PubInv/GlussCon/_posts/2015-08-24-stator-3d.md

---
layout: post
title: A 3D-printed Stator
---

<section class="content">
      <div class="jumbotron">
        <h1> A 3D-printed Stator</h1>
      </div>

<h1> Stator Design </h1>

<p>
With considerable effort, I created a 3D-printable design for the Gluss Pusher Stator.  The stator is the part that holds the coils. The pushrod holds the magnets.
</p>

Gluss Pusher Stator V24

<p>
I did this in Autodesk Fusion 360, and my design is freely <a href="https://fusion360.autodesk.com/projects/gluss-pusher-stator-v24">reusable</a> under Creative Commons Share Alike 4.0 license.
</p>

<br /><span xmlns:dct="http://purl.org/dc/terms/" href="http://purl.org/dc/dcmitype/Text" property="dct:title" rel="dct:type">Gluss Pusher Stator</span> by <a xmlns:cc="http://creativecommons.org/ns#" href="https://github.com/PubInv/PubInv" property="cc:attributionName" rel="cc:attributionURL">Robert L. Read</a> is licensed under a <a rel="license" href="http://creativecommons.org/licenses/by-sa/4.0/">Creative Commons Attribution-ShareAlike 4.0 International License</a>.<br />Based on a work at <a xmlns:dct="http://purl.org/dc/terms/" href="https://github.com/PubInv/PubInv" rel="dct:source">https://github.com/PubInv/PubInv</a>.

</section>
