PubInv/GlussCon/doc/figures/7TetController/7TetController.JPG

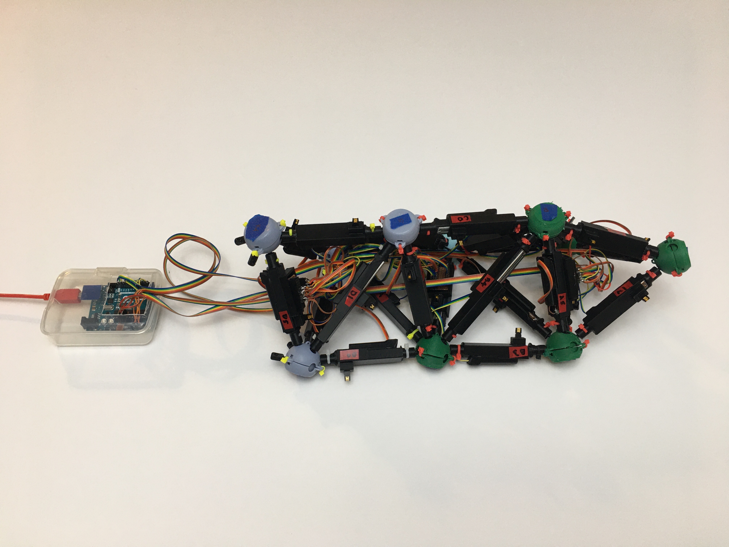
doc/figures/7TetController/7TetController.JPG
