PubInv/GlussCon/doc/figures/7TetController/BentArm.JPG

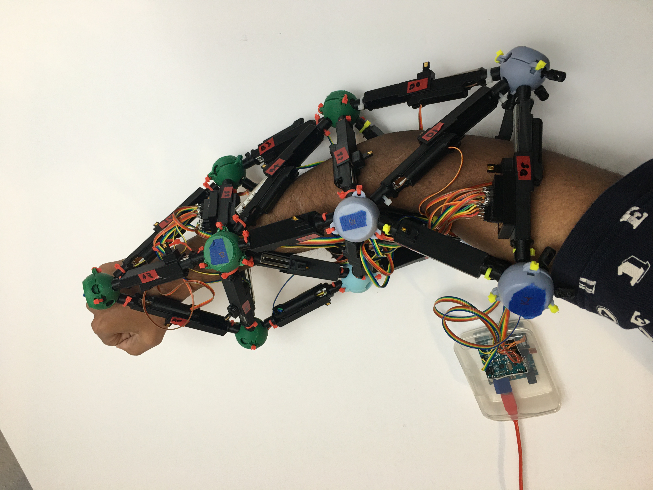
doc/figures/7TetController/BentArm.JPG
