PubInv/GlussCon/doc/figures/7TetController/JointAndSleeve.JPG

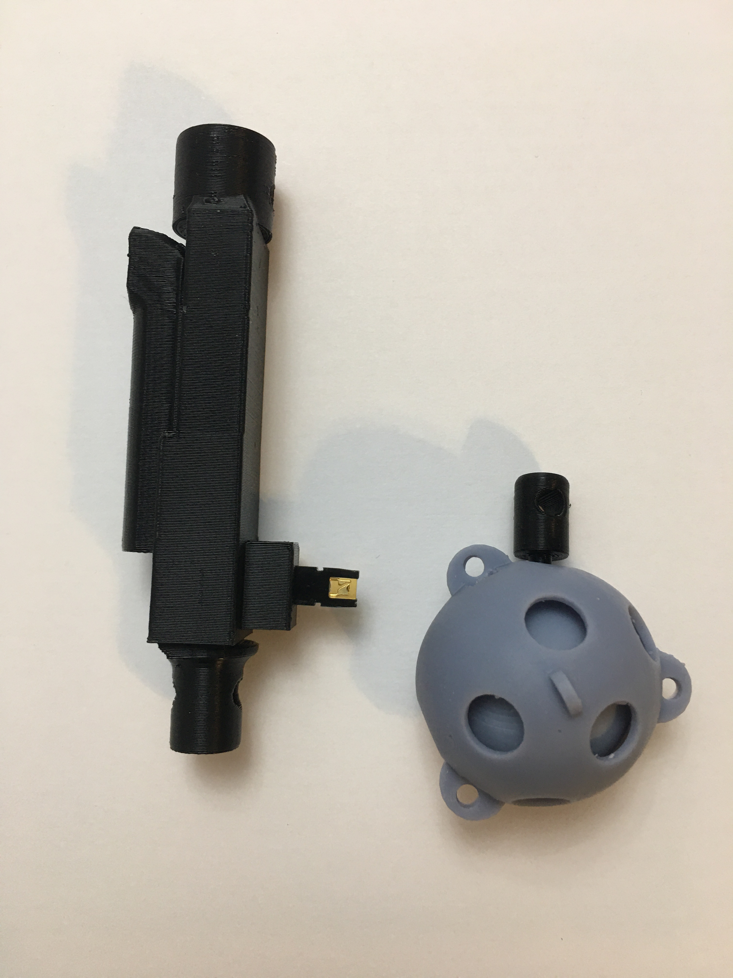
doc/figures/7TetController/JointAndSleeve.JPG
