PubInv/GlussCon/doc/figures/7TetController/StandingArm.JPG

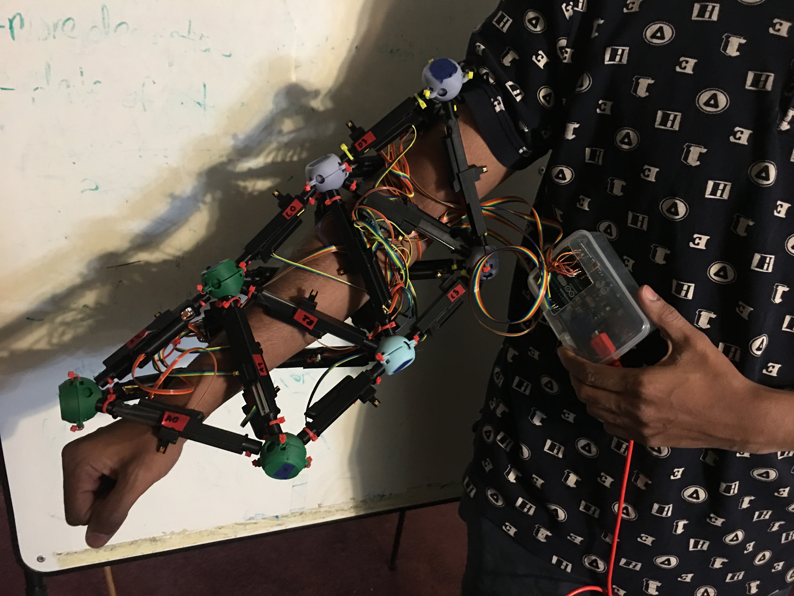
doc/figures/7TetController/StandingArm.JPG
