PubInv/GlussCon/doc/figures/7TetController/WristCloseUp.JPG

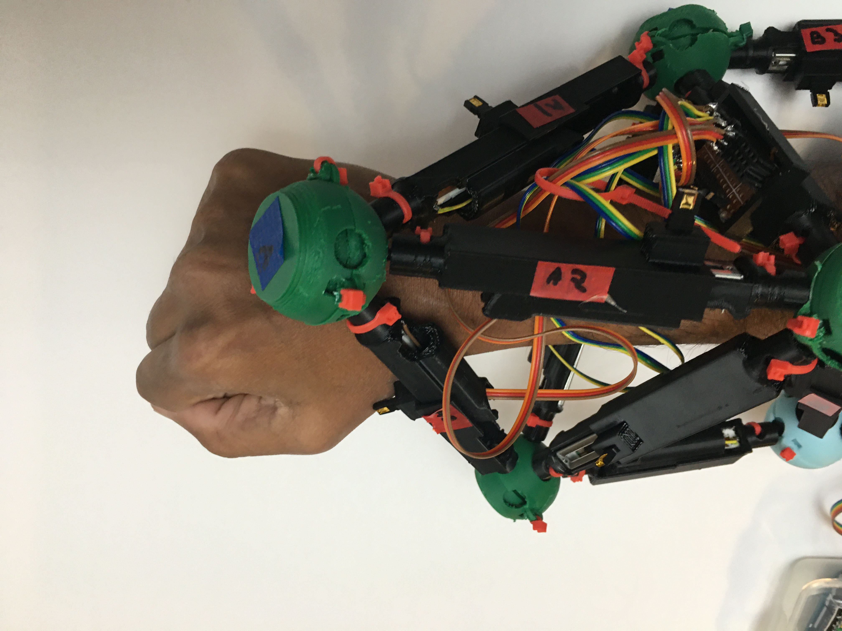
doc/figures/7TetController/WristCloseUp.JPG
