PubInv/GlussCon/doc/figures/ElbowFitting.JPG

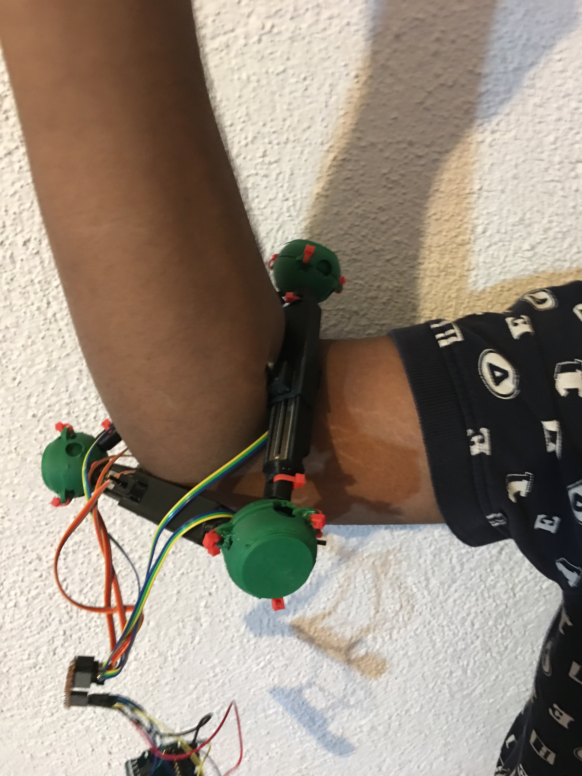
doc/figures/ElbowFitting.JPG
