PubInv/GlussCon/doc/figures/JointCloseUp.JPG

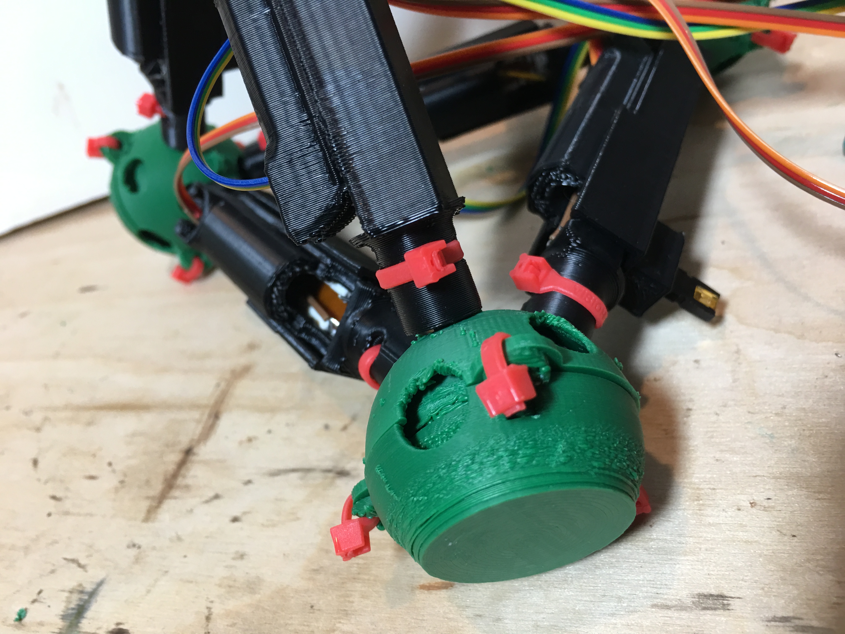
doc/figures/JointCloseUp.JPG
