PubInv/GlussCon/doc/figures/PotConnectionCloseUp.JPG

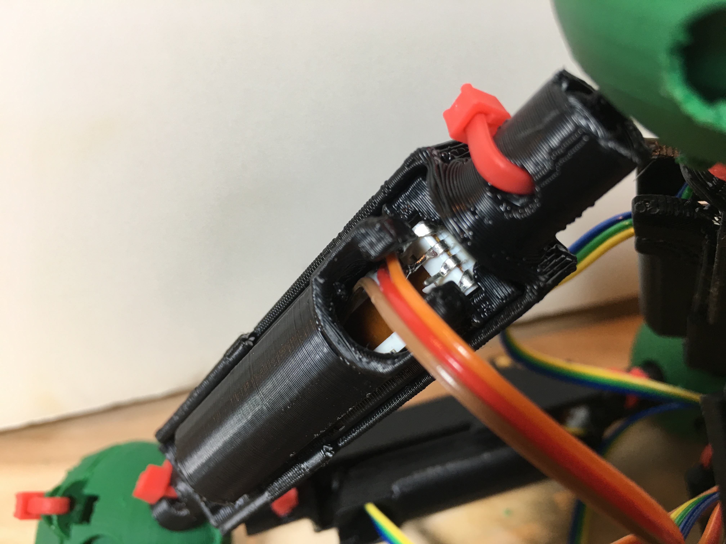
doc/figures/PotConnectionCloseUp.JPG
