PubInv/GlussCon/STLS/Upper Sleeve.STL

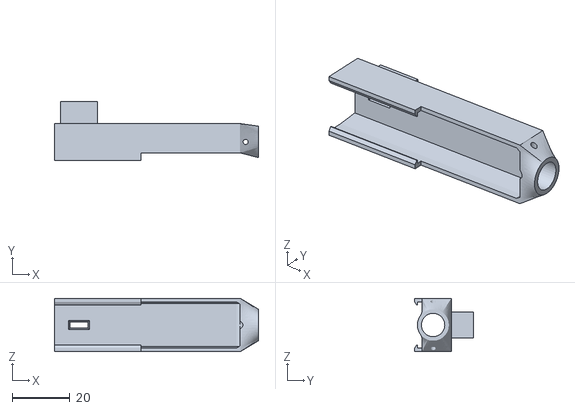
[picture p36: CAD file, 2017-01-15]
STLS/Upper Sleeve.STL
70.7 x 20.4 x 18.5
