PubInv/GlussCon/STLS/Pot Sleeve.STL

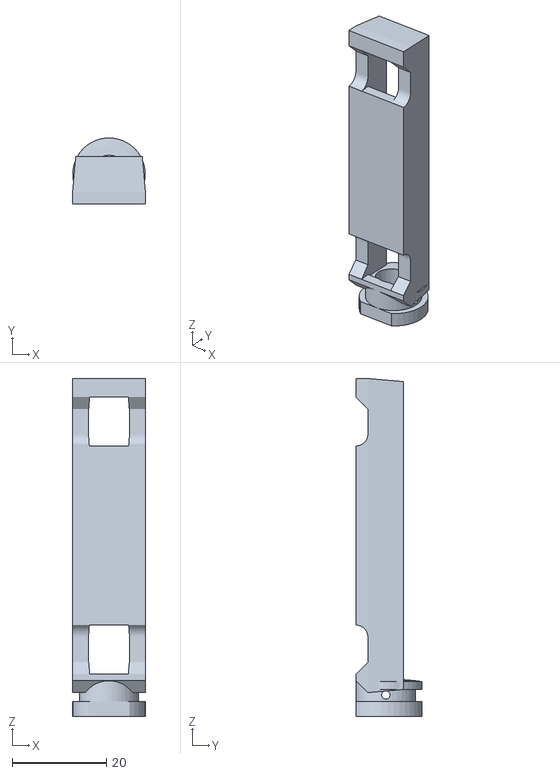
[picture p37: CAD file, 2017-01-15]
STLS/Pot Sleeve.STL
15.5 x 14.1 x 71.9
