PubInv/GlussCon/(threads)

Thread 1 (2016-12-21):

Power wire for Pot #4 is loose...

RobertLRead, 2016-12-21:
You can tell because the LED doesn't come on. If you push in on the wire it comes on.  Probably just needs to be resoldered.

Thread 3 (2016-12-21):

Some of the wires are too short.

RobertLRead, 2016-12-21:
In our next design we should probably fix this.

Thread 4 (2016-12-21):

It behooves us to solder a header into some ribbon cable....

RobertLRead, 2016-12-21:
If we put the 7 input wires in a single header, it will be far sturdier than the loose wires we have now.

RobertLRead, 2017-01-24:
Done!

Closed 2017-01-24.

Thread 5 (2016-12-21):

The 3D design has a right angle that catches on wires

RobertLRead, 2016-12-21:
a simple beveling in the next design will prevent it from catching during expansion.

Thread 10 (2017-03-18):

Build a new system or replace with lighter braided wire that has no spring

RobertLRead, 2017-03-18:
