PubInv/GlussCon/(commit log)

2017-01-11 Correcting my stupid misnumbering of the waldo pots
    [GlussCon.ino]
2017-01-15 adding potentiometer designs
    [Pot Sleeve.STL, Upper Sleeve.STL]
2019-09-15 change email case
